zhangci0226/typec-mt3608-fan-controller/img/clearfan.jpg

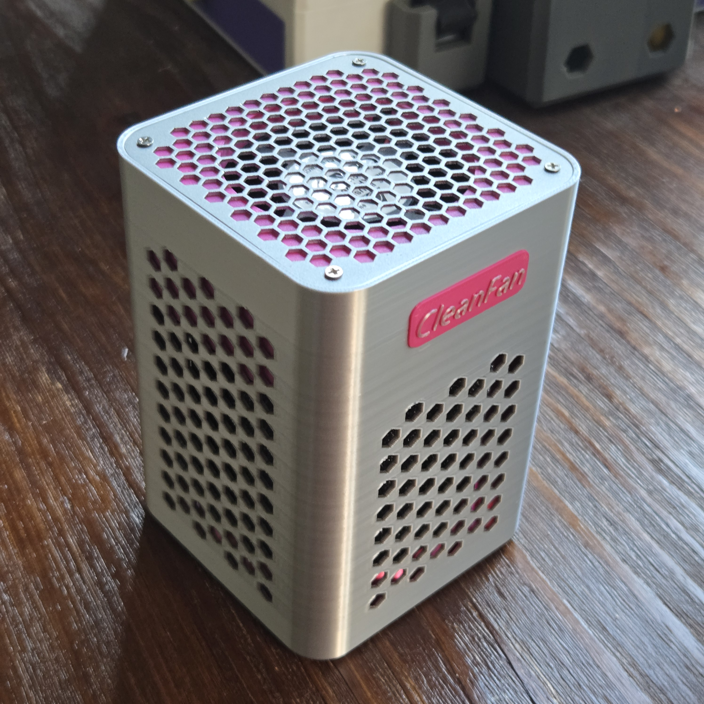
img/clearfan.jpg
