zhangci0226/typec-mt3608-fan-controller/img/hepa.jpg

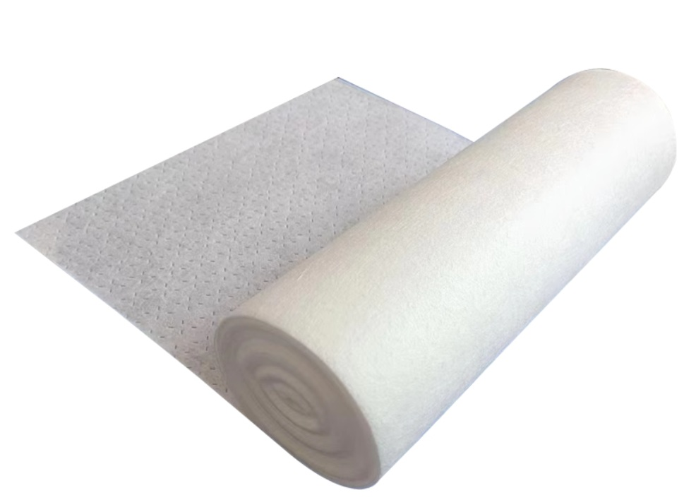
img/hepa.jpg
