zhangci0226/typec-mt3608-fan-controller/pcb/pcb.png

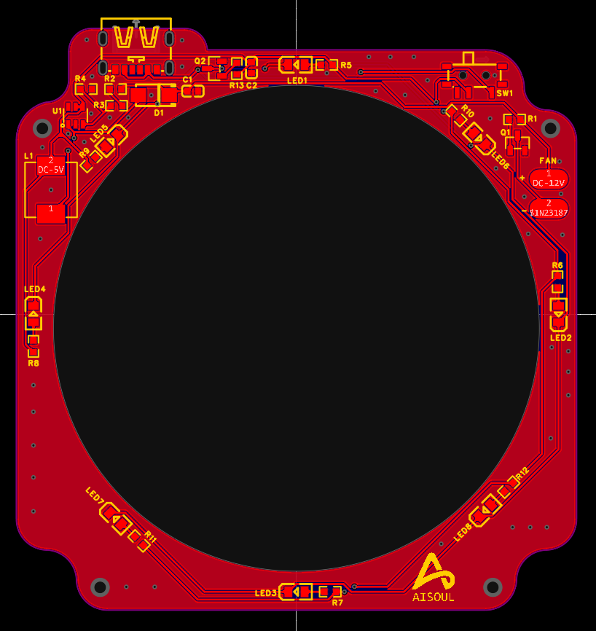
pcb/pcb.png
