zhangci0226/typec-mt3608-fan-controller/pcb/typec_power_pcb.png

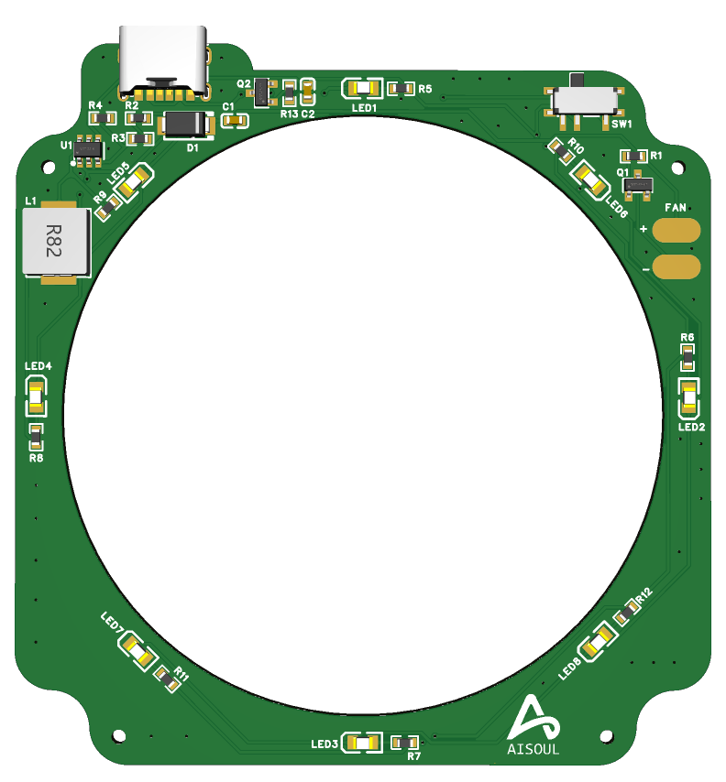
pcb/typec_power_pcb.png
