zhangci0226/typec-mt3608-fan-controller/3d_models/FAN6025.3mf

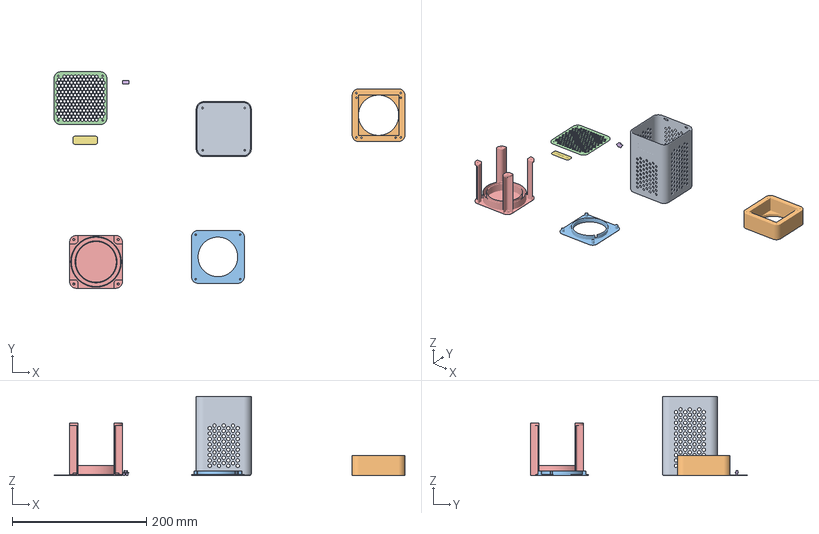
[picture p9: CAD file, 2025-07-15]
3d_models/FAN6025.3mf
523.4 x 322.9 x 117.8 mm
logo
