zhangci0226/typec-mt3608-fan-controller/schematic/typec_power.pdf

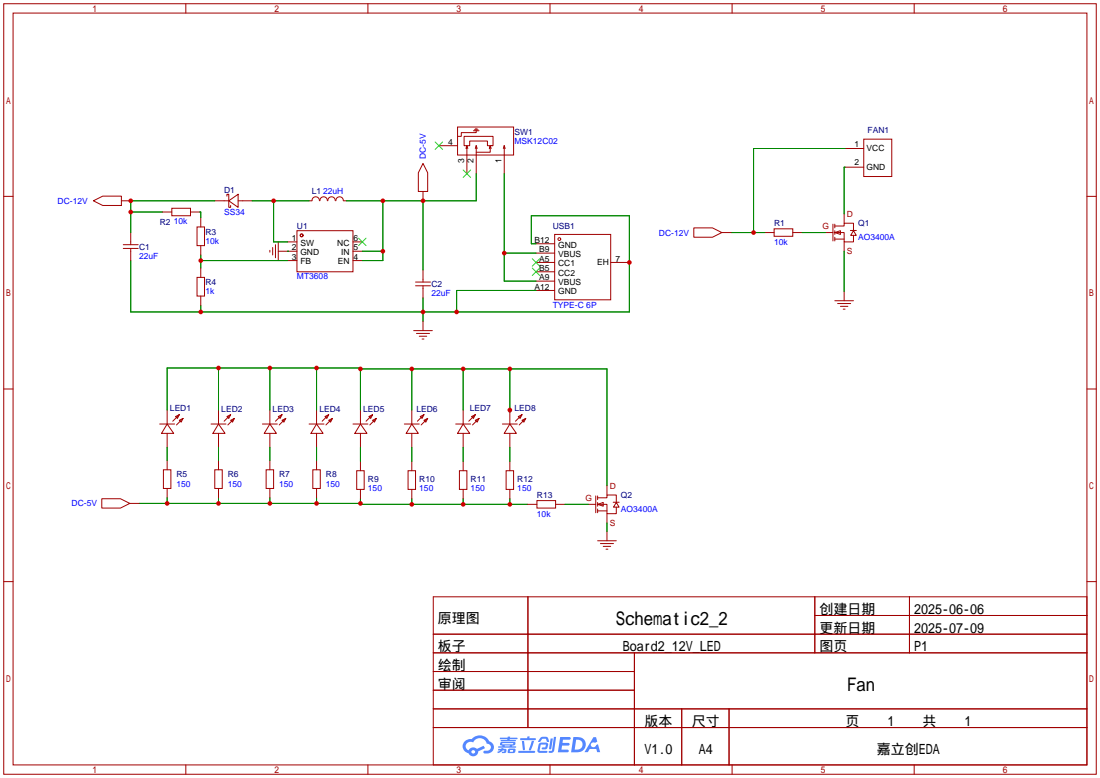
[picture p10: page 1]

原理图 | Schematic2_2 | 创建日期 | 2025-06-06

更新日期 | 2025-07-09

板子 | Board2_12V_LED | 图页 | P1
绘制 | | Fan
审阅

V1.0 | A4 | 嘉立创EDA
