zhangci0226/typec-mt3608-fan-controller/(list of files, drawings)

Other design files:
pcb/Fan_12V_LED.epro
