zhangci0226/typec-mt3608-fan-controller/(commit log)

2025-07-09 更新README.md，添加项目描述、用途、特性、原理图、BOM、制作步骤和使用方法，提供更详细的项目信息。
    [BOM.xlsx]
2025-07-09 更新README.md，修改风扇和LED控制描述，添加12V 6025暴力风扇信息，优化项目特性说明。
2025-07-09 更新README.md，修正风扇和LED控制部分的描述，补充12V 6025风扇的相关信息，进一步优化项目特性说明。
2025-07-09 更新README.md，修改许可证信息为Creative Commons Attribution-NonCommercial-ShareAlike 4.0，并补充使用条款说明。
2025-07-09 更新README.md，添加PCB冷却平台和3D打印外壳相关信息，补充电子元件和机械元件的详细说明，优化使用方法部分。
2025-07-12 更新README.md，修改项目名称为“CleanFan”，详细描述其功能和特点，添加双层过滤结构信息，更新电路板制作步骤及相关文件说明。
2025-07-15 更新README.md，添加PCB布线图，修改原理图文件名，删除不再使用的3D模型和PCB说明文件，更新BOM文件格式。
    [BOM.xlsx, FAN6025.3mf, Fan_12V_LED.epro]
2025-07-15 更新README.md，修改原理图预览图片路径为新的文件名。
2025-07-15 更新README.md，重新组织3D打印外壳部分，添加3mf文件格式说明，更新BOM表格格式及内容，补充机械元件信息，修改联系方式。
2025-07-15 更新README.md，优化BOM表格格式，添加电子元件类别信息，补充风扇和过滤的详细描述。
2025-07-15 更新README.md，修正风扇和过滤图片路径，确保图片链接正确。
2025-07-15 更新README.md，修正风扇和过滤图片的标记格式，确保图片正常显示。
2025-07-15 更新README.md，补充风扇规格说明，明确使用2线风扇以提高吸烟效果，同时更新风扇图片文件。
2025-07-15 更新README.md，添加产品图片，优化用途标题，确保信息更加清晰易懂。
2025-07-15 更新README.md，替换产品图片为GIF，补充3D打印外壳的材料和配色信息，简化制作步骤，确保内容更加直观易懂。
2025-07-15 更新README.md，修改BOM表格中的螺丝规格，补充风扇过滤信息，确保内容更加完整和清晰，同时更新风扇和3D模型图片文件。
2025-07-15 更新README.md，合并PCB布线图和渲染图为一张预览图，补充防震垫信息，确保内容更加完整和清晰。
2025-07-15 更新README.md，补充CleanFan尺寸信息，修改BOM表格中升压芯片和供电口的描述，优化风扇规格说明，确保内容更加准确和清晰。
2025-07-15 更新README.md，添加英文版本，优化内容结构，确保信息更加清晰易懂，同时补充了风扇和过滤的详细描述。
2025-07-15 更新README.md，优化内容结构，添加3D打印外壳的使用说明和材料信息，补充风扇和过滤的双重功能描述，确保信息更加清晰易懂。
